KDueck/MagLev/BottomBoard_Enbs.jpg

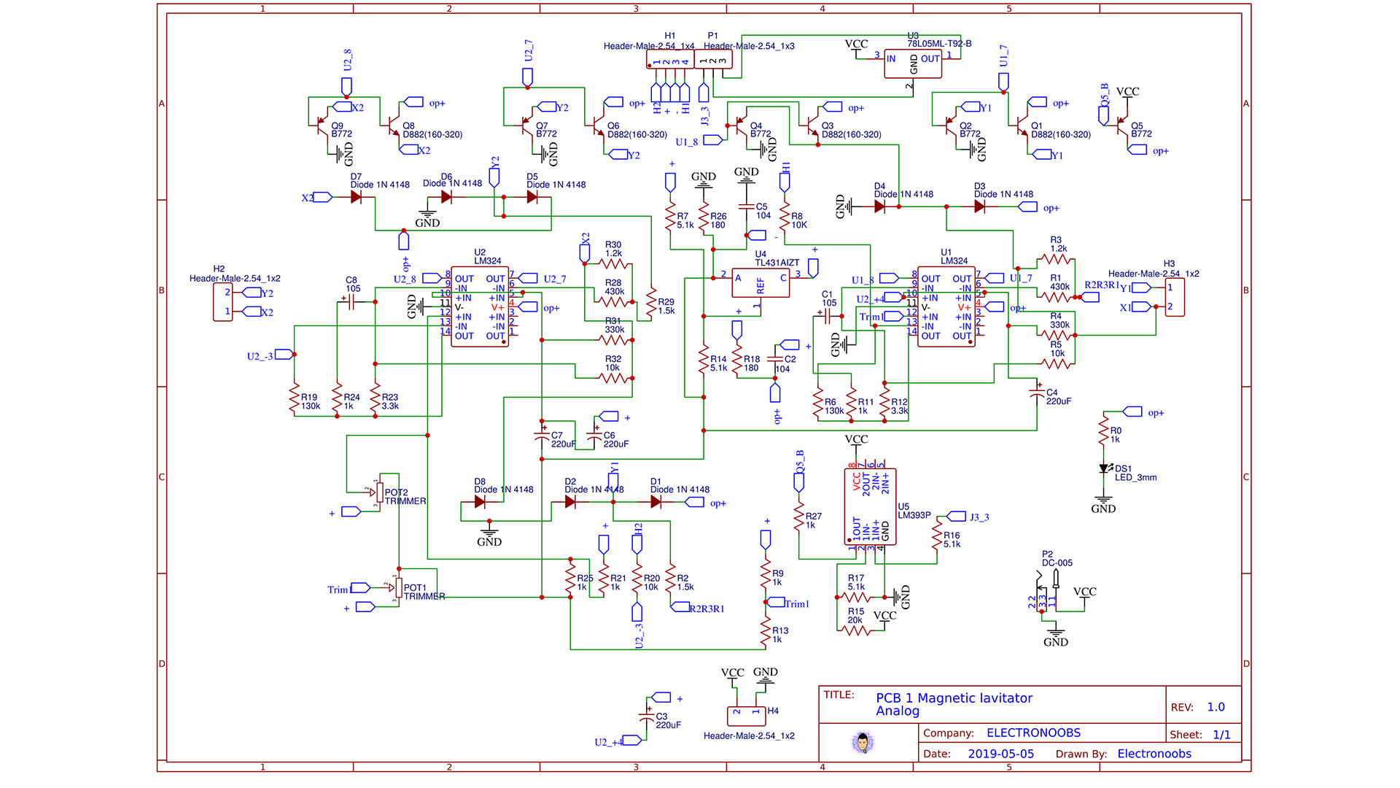
BottomBoard_Enbs.jpg
