KDueck/MagLev/TopBoard_Enbs.jpg

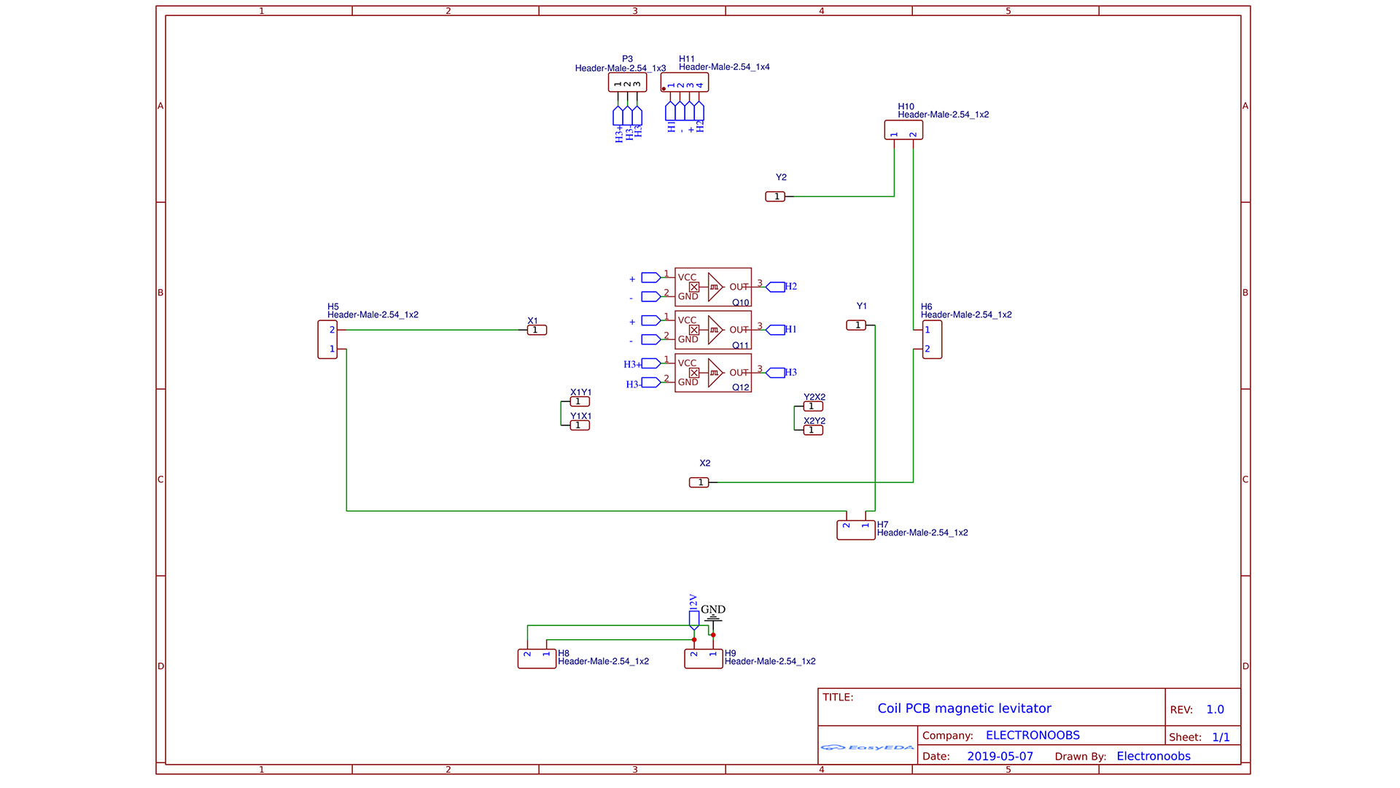
TopBoard_Enbs.jpg
