KDueck/MagLev/KiCad/MagLev/Maglev_coil.step

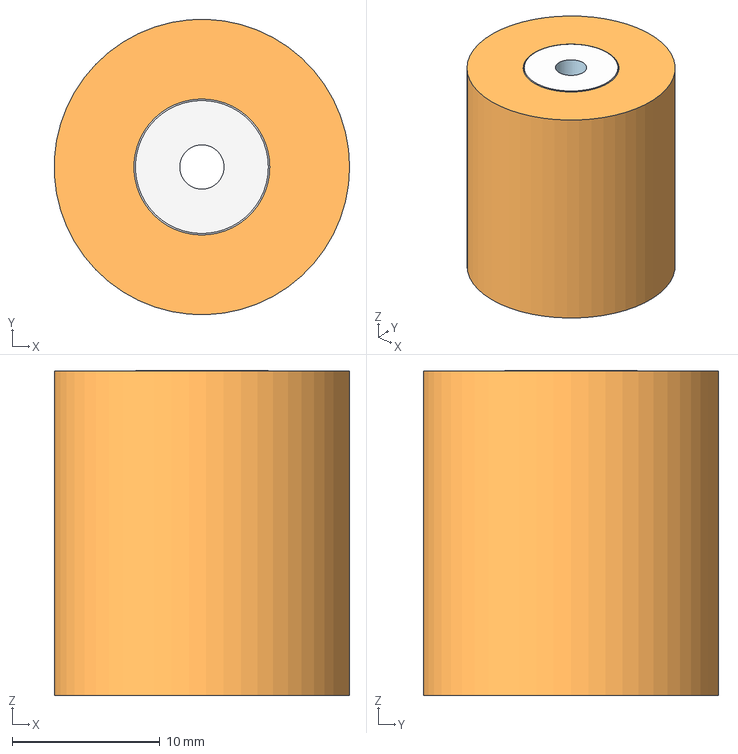
[picture p3: CAD file, 2023-08-11]
KiCad/MagLev/Maglev_coil.step
20.0 x 20.0 x 22.0 mm
