KDueck/MagLev/LtSpice/CoilDriver.asc

D1: diode
L1: ind; 7.4m; Rser=6
M1: nmos; Si7336ADP
Q1: npn
Q2: pnp
Q3: npn; 2SD2673
Q4: pnp; 2SB1708
R1: res; 1k
R2: res; 1k
R3: res; 1k
R4: res; {X}
R5: res; 10
V1: voltage; PULSE(0 5 0 1n 1n 125u 250u)
V2: voltage; 12
Named nets: 0, Vcc, Vsig
.tran 0 .01 .009
.step param X 1k 10k 1k
