KDueck/MagLev/LtSpice/MagLev_01.asc

+5V: voltage; 5
+12V: voltage; 12
C1: cap; .1µ
C2: cap; .1µ
D1: diode
M1: pmos
M2: nmos; irf530
Q1: pnp; 2SB1708
R1: res; 5.1k
R2: res; 5.1k
R3: res; 20k
R5: res; 5.1k
R6: res; 1k
R7: res; 12
R8: res; 180
R9: res; 5.1k
R10: res; 5.1k
R11: res; 180
R12: res; {X}
U2: opamp2; lm324
U3: TL431
Vsig_x: voltage; 2.5
Vsig_y: voltage; 2.72
Vsig_z: voltage; 2.72
Named nets: 0, +12V, +5V, DR, Vsig_z, Vsig_x, Vsig_y
.include lm324.txt
.include irf530.txt
.include tl431.txt
;tran 1
.dc Vsig_z 0 5
.step param X 50 500 50
