KDueck/MagLev/LtSpice/MagLev_03_enbs.asc

+5V: voltage; 5
+12V: voltage; 12
C1: cap; 560n
C2: cap; .1µ
C3: cap; .1µ
C4: cap; 0.4n
C5: cap; 4.5n
C6: cap; 220µ; Rser=0.16
C7: cap; 220µ; Rser=0.16
C8: cap; 30n
D2: diode; 1N4148
D3: diode; 1N4148
D4: diode; 1N4148
D5: diode; 1N4148
L1: ind; 7.4m; Rser=6
L2: ind; 7.4m; Rser=6
Q1: pnp; 2SB1708
Q2: npn; 2SD2673
Q3: pnp; 2SB1708
Q4: npn; 2SD2673
R1: res; 430k
R2: res; 1.2k
R3: res; 31k
R4: res; 180
R5: res; 5.1k
R6: res; 1.5k
R7: res; 5.1k
R8: res; 51
R9: res; 51
R10: res; 10k
R11: res; 1k
R12: res; 1k
R13: res; 3.3k
R14: res; 1k
R15: res; 130k
R16: res; 10k
R17: res; 1k
R18: res; 1k
R19: res; 0
R20: res; 180
U1: UniversalOpAmp2
U2: TL431
U3: UniversalOpAmp2
U4: opamp2; lm324
U5: UniversalOpAmp2
Vin: voltage; ""; AC 0.1
Vsig_x: voltage; 6
Vsig_y: voltage; 2.72
Vsig_z: voltage; 2.72
Named nets: 0, +12V, +5V, Vsig_z, Vsig_x, Vsig_y, DR, RL, Vref+, Vref-
.include lm324.txt
.include irf530.txt
.include tl431.txt
;.dc Vsig_x 3.5 8.5
Vout = -7.5(Vin - 2.5) + 2.5
.ac dec 100 1 100k
;.step dec param X 1n 100n 10
