KDueck/MagLev/LtSpice/MagLev_03_mod.asc

+5V: voltage; 5
+12V: voltage; 12
C1: cap; 560n
C2: cap; 560n
D2: diode; 1N4148
D3: diode; 1N4148
D4: diode; 1N4148
D5: diode; 1N4148
L1: ind; 7.4m; Rser=6
L2: ind; 7.4m; Rser=6
Q1: pnp; 2SB1708
Q2: npn; 2SD2673
Q3: pnp; 2SB1708
Q4: npn; 2SD2673
R1: res; 5k
R2: res; 5k
R3: res; 3.3k
R4: res; 10k
R5: res; 10k
R6: res; 10k
R8: res; 51
R9: res; 51
R10: res; 10k
R11: res; 10k
R12: res; 10k
R13: res; 3.3k
R14: res; 1k
R15: res; 75k
R16: res; 10k
R17: res; 5k
R18: res; 5k
R19: res; 1
R20: res; 1k
U1: UniversalOpAmp2
U2: UniversalOpAmp2
U3: UniversalOpAmp2
U4: opamp2; lm324
U6: UniversalOpAmp2
Vsig_x: voltage; 2.5; AC 0.1
Vsig_y: voltage; 2.72
Vsig_z: voltage; 2.72
Named nets: 0, +12V, +5V, Vsig_z, Vsig_x, Vsig_y, DR, RL
.include lm324.txt
.include irf530.txt
.dc Vsig_x 2 3
