KDueck/MagLev/LtSpice/MagLev_02.asc

+5V: voltage; 5
+12V: voltage; 12
D1: diode; 1N4148
D2: diode; 1N4148
D3: diode; 1N4148
D4: diode; 1N4148
L1: ind; 7.4m; Rser=6
L2: ind; 7.4m; Rser=6
Q1: pnp; 2SB1708
Q2: pnp; 2SB1708
Q3: npn; 2SD2673
Q4: npn; 2SD2673
R1: res; 1
R2: res; 3.3k
R3: res; 3.3k
R6: res; 10k
R8: res; 51
R9: res; 51
R10: res; 10k
R11: res; 10k
R12: res; 10k
U2: UniversalOpAmp2
U3: UniversalOpAmp2
Vsig_x: voltage; 2.5
Named nets: 0, +12V, +5V, Vsig_x, RL, DR
.include lm324.txt
.include irf530.txt
.dc Vsig_x 5 0
.lib opamp.sub
