KDueck/MagLev/LtSpice/MagLev_04.asc

+5V: voltage; 5
+12V: voltage; 12
C1: cap; 560n
D1: diode
D2: diode; 1N4148
D3: diode; 1N4148
D4: diode; 1N4148
D5: diode; 1N4148
L1: ind; 7.4m; Rser=6
L2: ind; 7.4m; Rser=6
M1: pmos
M2: nmos; irf530
Q1: pnp; 2SB1708
Q2: npn; 2SD2673
Q3: pnp; 2SB1708
Q4: npn; 2SD2673
Q5: pnp; 2SB1708
R1: res; 10k
R2: res; 24k
R3: res; 100k
R4: res; 20k
R5: res; 5.1k
R6: res; 10k
R7: res; 3.3k
R8: res; 51
R9: res; 51
R10: res; 10k
R11: res; 10k
R12: res; 10k
R13: res; 3.3k
R14: res; 1k
R15: res; 75k
R16: res; 10k
R17: res; 5k
R18: res; 5k
R19: res; 1
R20: res; 1.2k
U1: opamp2; lm324
U2: opamp2; lm324
U3: opamp2; lm324
U4: opamp2; lm324
U5: opamp2; lm324
Vsig_x: voltage; 2.5
Vsig_y: voltage; 2.72
Vsig_z: voltage; 3
Named nets: 0, +12V, +5V, DR, Vsig_z, Vsig_x, Vsig_y, RL
.include lm324.txt
.include irf530.txt
.dc Vsig_x 0 5
Vout = -10(Vin - 2.72) + 2.72
Z Axis enable circuit
Output turns on at Vsig_z > 2.5V
