KDueck/MagLev/LtSpice/PushPull.asc

Q1: pnp; 2SB1708
Q2: npn; 2SD2673
Q3: pnp; 2SB1708
Q4: npn; 2SD2673
R1: res; 100
R2: res; 1
R3: res; 1
R4: res; 10k
R5: res; 10k
R6: res; 10k
R7: res; 10k
U1: UniversalOpAmp2
V1: voltage; 12
Vsig_z1: voltage; 2.72
Named nets: +12V, 0, DR, RL, Vsig, Vsig_inv
.dc Vsig_z1 -0 12
.include lm324.txt
.include irf530.txt
