KDueck/MagLev/KiCad/MagLev/MagLev.kicad_pcb

## KiCad design KiCad/MagLev/MagLev.kicad_pcb (2023-08-11)

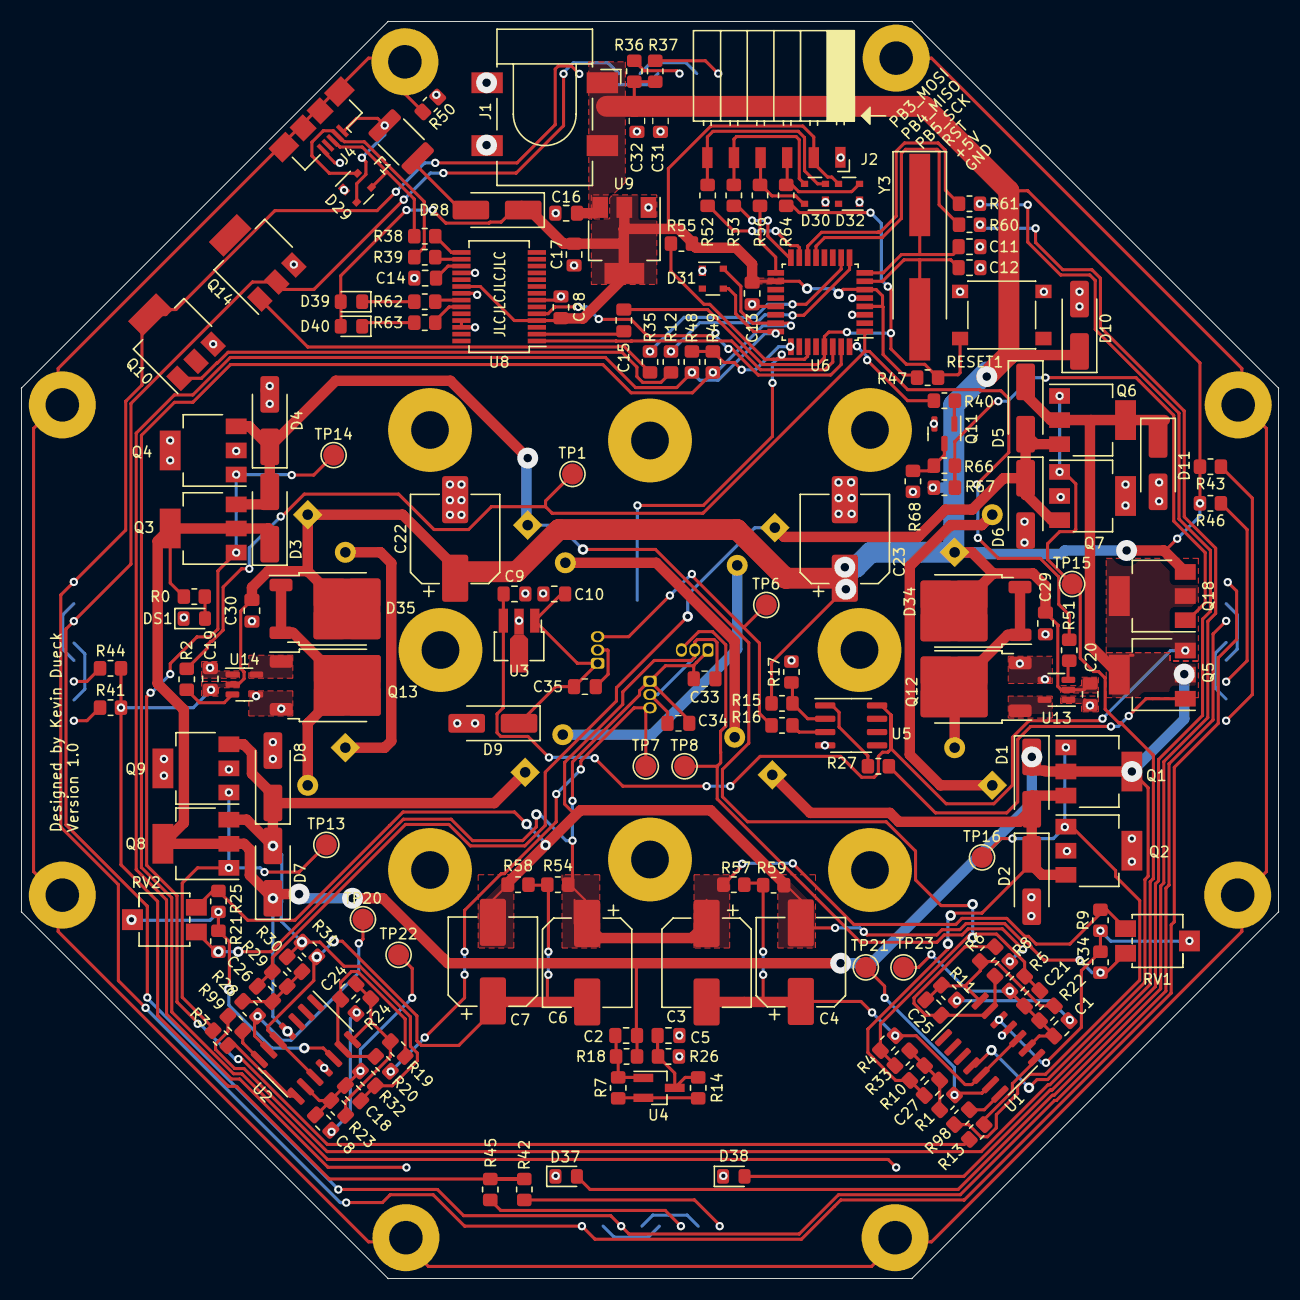
[picture p4: board MagLev.kicad_pcb from above]

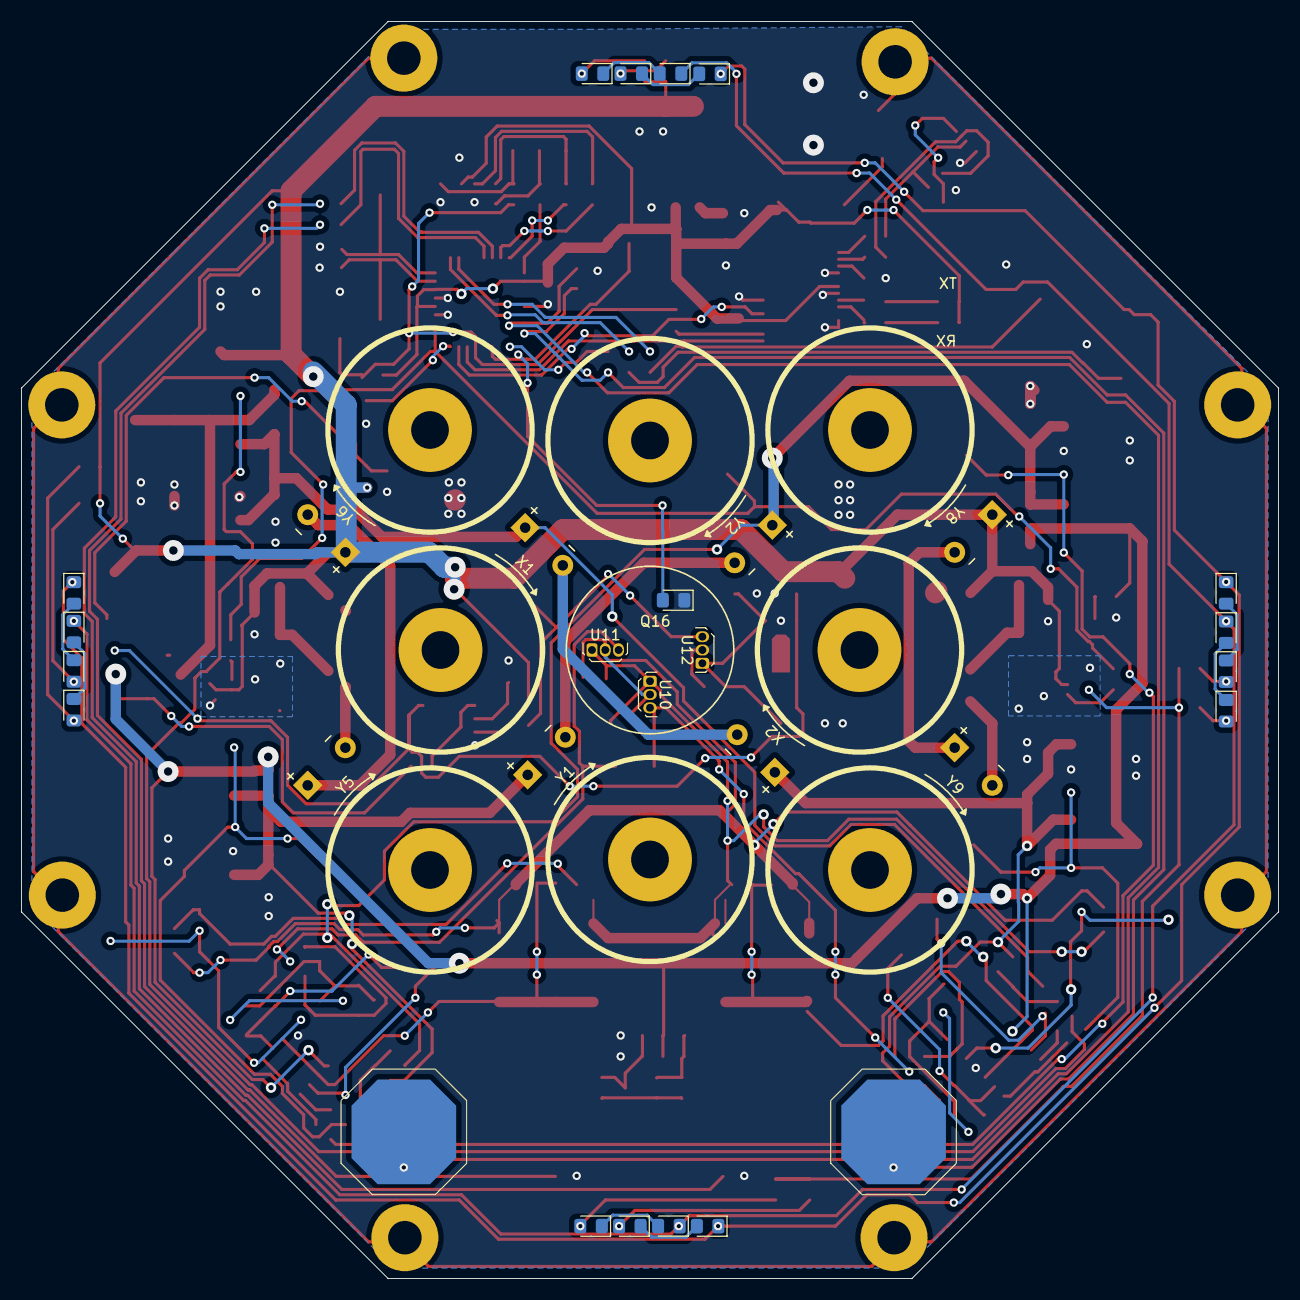
[picture p5: board MagLev.kicad_pcb from below]

Board: 2 copper layers, 120.0 x 120.0 mm, 211 parts (30 on the bottom side), 117 nets.

Parts:
C1, C8: 1uF; C_0805_2012Metric_Pad1.18x1.45mm_HandSolder
C2, C5: .1uF; C_0805_2012Metric_Pad1.18x1.45mm_HandSolder
C3, C4, C6, C7, C22, C23: 220uF; CP_Elec_8x10_HandSolder
C9: 0.33uF; C_0805_2012Metric_Pad1.18x1.45mm_HandSolder
C10: 0.01uF; C_0805_2012Metric_Pad1.18x1.45mm_HandSolder
C11, C12: 22pF; C_0805_2012Metric_Pad1.18x1.45mm_HandSolder
C13, C19, C20, C28, C32, C33, C34, C35: 0.1uF; C_0805_2012Metric_Pad1.18x1.45mm_HandSolder
C14, C15: 100nF; C_0805_2012Metric_Pad1.18x1.45mm_HandSolder
C16, C17: 10uF; C_0805_2012Metric_Pad1.18x1.45mm_HandSolder
C18, C21: 4.5nF; C_0805_2012Metric_Pad1.18x1.45mm_HandSolder
C24, C25: 0.4nF; C_0805_2012Metric_Pad1.18x1.45mm_HandSolder
C26, C27: 30nF; C_0805_2012Metric_Pad1.18x1.45mm_HandSolder
C29, C30, C31: 4.7uF; C_0805_2012Metric_Pad1.18x1.45mm_HandSolder
D1, D2, D3, D4, D5, D6, D7, D8: B140; D_SMA_Handsoldering
D9: SMAJ5.0A; D_SMA_Handsoldering
D10, D11: SMAJ12A; D_SMA_Handsoldering
D12, D13, D14, D15, D16, D17, D18, D19, D20, D21, D22, D23, D24, D25, D26, D27: LED; LED_0805_2012Metric_Pad1.15x1.40mm_HandSolder
D28: D; D_SMA_Handsoldering
D29, D30, D31, D32: SP0503BAHT; SOT-143
D34, D35: MBRD1060; TO-252-Schottkey
D37, D38: Yellow; LED_0805_2012Metric_Pad1.15x1.40mm_HandSolder
D39: Green; LED_0805_2012Metric_Pad1.15x1.40mm_HandSolder
D40: Red; LED_0805_2012Metric_Pad1.15x1.40mm_HandSolder
DS1: LED; LED_0805_2012Metric_Pad1.15x1.40mm_HandSolder
F1: MF-MSMF050-2; Fuse_1812_4532Metric_Pad1.30x3.40mm_HandSolder
H1, H2, H3, H4, H5, H6, H7, H8: MountingHole_Pad; MountingHole_3.2mm_M3_Pad
J1: FC681465S; BarrelJack_CLIFF_FC681465S_SMT_Horizontal_No_Holes
J2: Programming header; PinSocket_1x06_P2.54mm_Horizontal_SM
J4: USB_B_Micro; USB_Micro-B_Amphenol_10104110_Horizontal_Overhang
PB1, PB2: Capacitive_Touch_Pad
Q1, Q3, Q6, Q8, Q10, Q14: ZX5T851GTA; SOT-223-3_TabPin2_BJT
Q2, Q4, Q5, Q7, Q9, Q18: ZX5T1951GTA; SOT-223-3_TabPin2_BJT
Q11: MMBT3904; SOT-23
Q12, Q13: AOD442G; TO-252-2
Q16: TEMT7000X01; LED_0805_2012Metric_Pad1.15x1.40mm_HandSolder
R0: 1000; R_0805_2012Metric_Pad1.20x1.40mm_HandSolder
R1, R28: 430k; R_0805_2012Metric_Pad1.20x1.40mm_HandSolder
R2, R9, R11, R12, R21, R24, R25, R27, R34, R35, R38, R39, R40, R47, R51, R52, R53, R54, R56, R57, R58, R59, R64, R66: 1k; R_0805_2012Metric_Pad1.20x1.40mm_HandSolder
R3, R13, R98, R99: 51; R_0805_2012Metric_Pad1.20x1.40mm_HandSolder
R4, R31: 330k; R_0805_2012Metric_Pad1.20x1.40mm_HandSolder
R5, R8, R20, R32, R67: 10k; R_0805_2012Metric_Pad1.20x1.40mm_HandSolder
R6, R19: 130k; R_0805_2012Metric_Pad1.20x1.40mm_HandSolder
R7, R14, R16, R17: 5.1k; R_0805_2012Metric_Pad1.20x1.40mm_HandSolder
R10, R29: 1.5k; R_0805_2012Metric_Pad1.20x1.40mm_HandSolder
R15: 20k; R_0805_2012Metric_Pad1.20x1.40mm_HandSolder
R18, R26: 180; R_0805_2012Metric_Pad1.20x1.40mm_HandSolder
R22, R23: 3.3k; R_0805_2012Metric_Pad1.20x1.40mm_HandSolder
R30, R33: 1.2k; R_0805_2012Metric_Pad1.20x1.40mm_HandSolder
R36, R37, R41, R42, R43, R44, R45, R46: 270; R_0805_2012Metric_Pad1.20x1.40mm_HandSolder
R48, R49, R50: 1M; R_0805_2012Metric_Pad1.20x1.40mm_HandSolder
R55: 5k; R_0805_2012Metric_Pad1.20x1.40mm_HandSolder
R60, R61: 145; R_0805_2012Metric_Pad1.20x1.40mm_HandSolder
R62, R63: 300; R_0805_2012Metric_Pad1.20x1.40mm_HandSolder
R68: 0; R_0805_2012Metric_Pad1.20x1.40mm_HandSolder
RESET1: PTS645; SW_SPST_PTS645
RV1, RV2: 10k; Potentiometer_ST-4EB
TP1: CoilPWM; TestPoint_Pad_D2.0mm
TP6: Hz; TestPoint_Pad_D2.0mm
TP7: Hx; TestPoint_Pad_D2.0mm
TP8: Hy; TestPoint_Pad_D2.0mm
TP13, TP14: Gx; TestPoint_Pad_D2.0mm
TP15, TP16: Gy; TestPoint_Pad_D2.0mm
TP20, TP21: Yin; TestPoint_Pad_D2.0mm
TP22, TP23: Xin; TestPoint_Pad_D2.0mm
U1, U2: LM324; SOIC-14_3.9x8.7mm_P1.27mm
U3: L78L05_SO8; SOT-89-3_Handsoldering_Vref
U4: TL431A; SOT-23_Handsoldering
U5: LM393; SOIC-8_3.9x4.9mm_P1.27mm
U6: ATmega328P-A; TQFP-32_7x7mm_P0.8mm
U8: FT232RL; SSOP-28_5.3x10.2mm_P0.65mm
U9: LM1117MP-5.0; SOT-223-3_TabPin2
U10, U11, U12: DRV5505; TO-92Flat
U13, U14: MCP1402; SOT-23-5
X1, X2: L_Ferrite; Maglev_coil
Y1, Y2, Y5, Y6, Y8, Y9: L_Ferrite; Maglev_coil
Y3: J49SMH-16MHz; Crystal_SMD_HC49-SD_HandSoldering

Connections:
+5V: C13.1, C17.1, C28.1, D28.1 (K), D32.3 (K), D39.2 (A), D40.2 (A), J2.2, R47.2, R55.1, U6.4 (VCC), U6.6 (VCC), U6.18 (AVCC), U8.4 (VCCIO), U8.20 (VCC), U9.2 (VO)
/CoilPWM: R2.1, R51.1, TP1.1, U6.1 (PD3)
/DR: C2.1, D1.1 (K), D3.1 (K), D5.1 (K), D7.1 (K), D11.1 (A1), Q1.1 (C), Q3.1 (C), Q5.1 (C), Q6.1 (C), Q8.1 (C), R0.1, R18.2, U1.4 (V+), U2.4 (V+)
/En_sig: R40.2, U6.32 (PD2)
/H1: R8.2, TP8.1, U11.3 (OUTPUT)
/H2: R20.2, TP7.1, U10.3 (OUTPUT)
/MCU/LED1: R60.2, U6.13 (PB1)
/MCU/LED2: R61.2, U6.14 (PB2)
/MCU/LED_UV: R35.2, U6.10 (PD6)
/MCU/LED_WH: R12.2, U6.9 (PD5)
/MCU/LightSense: Q16.2 (C), R55.2, U6.27 (PC4)
/MCU/PB3_MOSI: R52.1, U6.15 (PB3)
/MCU/PB4_MISO: R53.1, U6.16 (PB4)
/MCU/PB5_SCK: R56.1, U6.17 (PB5)
/MCU/RESET: C15.1, R47.1, R64.1, RESET1.1, U6.29 (~RESET/PC6)
/MCU/RXD0: U6.30 (PD0), U8.1 (TXD)
/MCU/TXD0: U6.31 (PD1), U8.5 (RXD)
/MCU/Touch1: D31.3 (K), PB1.1 (Out), R48.1, U6.24 (PC1)
/MCU/Touch2: D31.4 (K), PB2.1 (Out), R49.1, U6.23 (PC0)
/MCU/TouchCom: R48.2, R49.2, U6.25 (PC2)
/Vcc_en: C9.1, Q5.3 (E), Q18.1 (C), U3.3 (IN), U5.8 (V+)
/Vref+: C3.1, C6.1, C33.1, C34.1, R9.2, R21.2, R54.1, R57.1, RV1.3, RV2.3, U10.1 (VDD), U11.1 (VDD)
/Vref-: C4.2, C7.2, C33.2, C34.2, R25.2, R34.2, R58.2, R59.2, RV1.1, RV2.1, U10.2 (GND), U11.2 (GND)
/Vreg: C10.1, C35.1, D9.1 (A1), U3.1 (OUT), U12.1 (VDD)
/X1: C21.1, D3.2 (A), D4.1 (K), Q3.3 (E), Q4.3 (E), R4.2, R5.2, R33.2, Y2.1
/X2: C18.1, D7.2 (A), D8.1 (K), Q8.3 (E), Q9.3 (E), R30.2, R31.2, R32.2, X2.1
/Y1: C27.1, D1.2 (A), D2.1 (K), Q1.3 (E), Q2.3 (E), R10.1, Y1.1
/Y2: C26.1, D5.2 (A), D6.1 (K), Q6.3 (E), Q7.3 (E), R29.1, X1.1
Earth: H1.1, H2.1, H3.1, H4.1, H5.1, H6.1, H7.1, H8.1, J4.6 (Shield), R50.2
GND: C5.2, C9.2, C10.2, C11.2, C12.2, C13.2, C14.2, C16.2, C17.2, C19.2, C20.2, C22.2, C23.2, C28.2, C29.2, C30.2, C31.2, C32.2, C35.2, D2.2 (A), D4.2 (A), D6.2 (A), D8.2 (A), D9.2 (A2), D10.2 (A2), D11.2 (A2), D29.1 (A), D30.1 (A), D31.1 (A), D32.1 (A), D37.1 (K), D38.1 (K), DS1.1 (K), J1.2, J1.3, J2.1, J4.5 (GND), Q2.1 (C), Q4.1 (C), Q7.1 (C), Q9.1 (C), Q10.3 (E), Q11.2 (E), Q12.3 (S), Q13.3 (S), Q14.3 (E), Q16.1 (E), R17.2, R26.1, R50.1, R68.2, RESET1.2, U1.11 (V-), U2.11 (V-), U3.2 (GND), U5.4 (V-), U6.3 (GND), U6.5 (GND), U6.21 (GND), U8.7 (GND), U8.18 (GND), U8.21 (GND), U8.25 (AGND), U8.26 (TEST), U9.1 (GND), U12.2 (GND), U13.1 (GND), U13.4 (GND), U14.1 (GND), U14.4 (GND)
unnamed: C1.1, R11.1
unnamed: C8.1, R24.1
unnamed: C24.1, R19.1, R23.2, R24.2, U2.14
unnamed: C25.1, R6.1, R11.2, R22.2, U1.14
unnamed: C26.2, R28.1, R29.2, R30.1
unnamed: C27.2, R1.1, R10.2, R33.1
unnamed: D12.2 (A), R36.1
unnamed: D12.1 (K), D13.2 (A)
unnamed: D13.1 (K), D15.1 (K), D17.1 (K), D19.1 (K), Q10.1 (C)
unnamed: D14.2 (A), R44.1
unnamed: D14.1 (K), D15.2 (A)
unnamed: D16.2 (A), R45.1
unnamed: D16.1 (K), D17.2 (A)
unnamed: D18.2 (A), R46.1
unnamed: D18.1 (K), D19.2 (A)
unnamed: D20.2 (A), R37.1
unnamed: D20.1 (K), D21.2 (A)
unnamed: D21.1 (K), D23.1 (K), D25.1 (K), D27.1 (K), Q14.1 (C)
unnamed: D22.2 (A), R41.1
unnamed: D22.1 (K), D23.2 (A)
unnamed: D24.2 (A), R42.1
unnamed: D24.1 (K), D25.2 (A)
unnamed: D26.2 (A), R43.1
unnamed: D26.1 (K), D27.2 (A)
unnamed: D28.2 (A), F1.1
unnamed: D34.2 (A), Q12.2 (D), Y5.2
unnamed: D35.2 (A), Q13.2 (D), Y9.2
unnamed: D37.2 (A), R60.1
unnamed: D38.2 (A), R61.1
unnamed: D39.1 (K), R62.1
unnamed: D40.1 (K), R63.1
unnamed: DS1.2 (A), R0.2
unnamed: D32.2 (K), J2.3, R64.2
unnamed: D30.4 (K), J2.4, R56.2
unnamed: D30.3 (K), J2.5, R53.2
unnamed: D30.2 (K), J2.6, R52.2
unnamed: D29.3 (K), J4.3 (D+), R38.1
unnamed: D29.4 (K), J4.2 (D-), R39.2
unnamed: D29.2 (K), F1.2, J4.1 (VBUS)
unnamed: Q1.2 (B), Q2.2 (B), R98.1, TP16.1
unnamed: Q3.2 (B), Q4.2 (B), R13.1, TP14.1
unnamed: Q5.2 (B), R27.2
unnamed: Q6.2 (B), Q7.2 (B), R99.1, TP15.1
unnamed: Q8.2 (B), Q9.2 (B), R3.1, TP13.1
unnamed: Q10.2 (B), R12.1
unnamed: Q11.1 (B), R40.1
unnamed: Q11.3 (C), R66.2, R68.1
unnamed: Q12.1 (G), U13.5 (OUT)
unnamed: Q13.1 (G), U14.5 (OUT)
unnamed: Q14.2 (B), R35.1
unnamed: Q18.2 (B), R66.1, R67.1
unnamed: R3.2, U2.8
unnamed: R13.2, U1.8
unnamed: R27.1, U5.1
unnamed: R98.2, U1.7
unnamed: R99.2, U2.7
unnamed: C3.2, C4.1, R4.1, R57.2, R59.1, U1.5 (+), U1.10 (+)
unnamed: R1.2, TP21.1, U1.6 (-)
unnamed: C1.2, C21.2, R5.1, R22.1, TP23.1, U1.9 (-)
unnamed: R9.1, R34.1, RV1.2, U1.12 (+)
unnamed: C25.2, R6.2, R8.1, U1.13 (-)
unnamed: C6.2, C7.1, R31.1, R54.2, R58.1, U2.5 (+), U2.10 (+)
unnamed: R28.2, TP20.1, U2.6 (-)
unnamed: C8.2, C18.2, R23.1, R32.1, TP22.1, U2.9 (-)
unnamed: R21.1, R25.1, RV2.2, U2.12 (+)
unnamed: C24.2, R19.2, R20.1, U2.13 (-)
unnamed: C5.1, R14.2, R26.2, U4.3 (A)
unnamed: C2.2, R7.2, R18.1, U4.1 (C)
unnamed: R7.1, R14.1, U4.2 (Ref)
unnamed: R16.1, U5.3 (+)
unnamed: R15.2, R17.1, U5.2 (-)
unnamed: C12.1, U6.7 (XTAL1/PB6), Y3.2
unnamed: C11.1, U6.8 (XTAL2/PB7), Y3.1
unnamed: C14.1, U8.17 (3V3OUT)
unnamed: R63.2, U8.23 (CBUS0)
unnamed: R62.2, U8.22 (CBUS1)
unnamed: C15.2, U8.2 (DTR)
unnamed: R38.2, U8.15 (USBD+)
unnamed: R39.1, U8.16 (USBD-)
unnamed: R16.2, TP6.1, U12.3 (OUTPUT)
unnamed: R51.2, U13.3 (IN)
unnamed: R2.2, U14.3 (IN)
unnamed: X1.2, X2.2
unnamed: Y1.2, Y2.2
unnamed: Y5.1, Y6.2
unnamed: Y8.2, Y9.1
VCC: C16.1, C19.1, C20.1, C22.1, C23.1, C29.1, C30.1, C31.1, C32.1, D10.1 (A1), D34.1 (K), D35.1 (K), J1.1, Q18.3 (E), R15.1, R36.2, R37.2, R41.2, R42.2, R43.2, R44.2, R45.2, R46.2, R67.2, U9.3 (VI), U13.2 (Vdd), U14.2 (Vdd), Y6.1, Y8.1
