KDueck/MagLev/(commit log)

2023-08-05 Initial commit.
    [MagLev.kicad_pcb, MagLev.kicad_sch]
2023-08-05 Start schematic, add hierarchical sheet.
    [X2Y2_Axis.kicad_sch]
2023-08-11 Version 1.0 release.
    [MCU.kicad_sch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]
